Franck78/NANAO-MS8_29/SHIC101.jpg

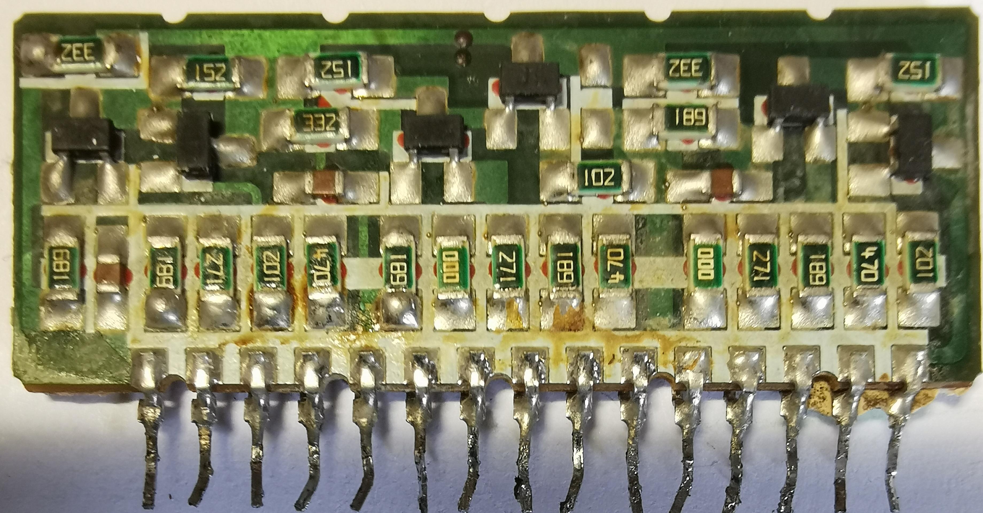
SHIC101.jpg
