Franck78/NANAO-MS8_29/SHIC103-b.jpg

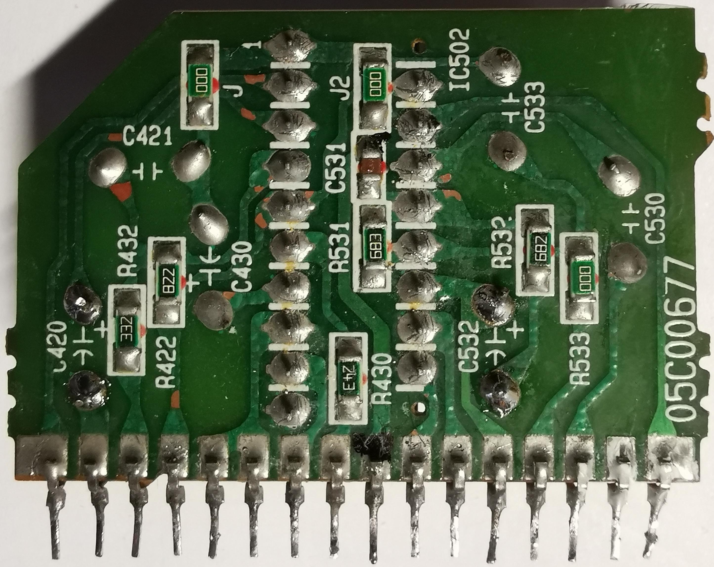
SHIC103-b.jpg
