Franck78/NANAO-MS8_29/SHIC102.jpg

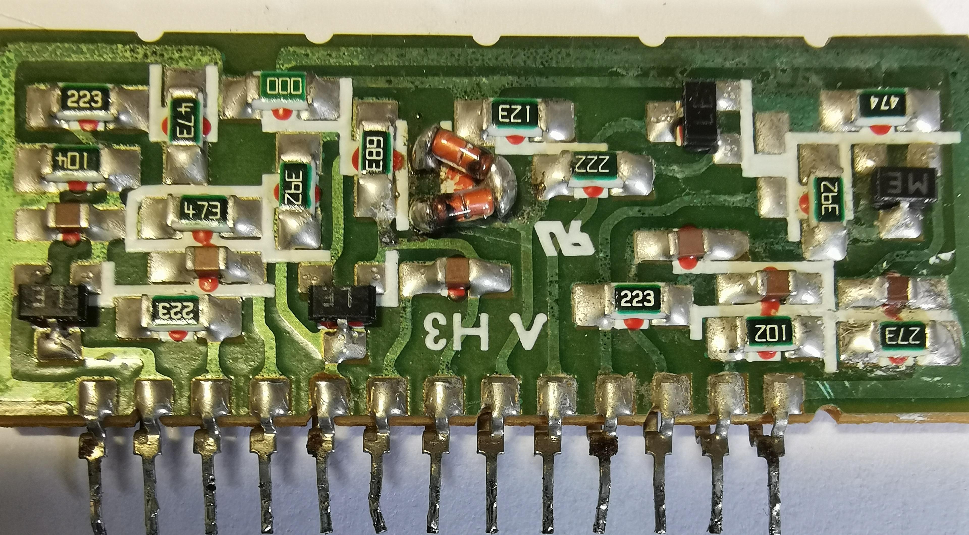
SHIC102.jpg
