Franck78/NANAO-MS8_29/SHIC103-a.jpg

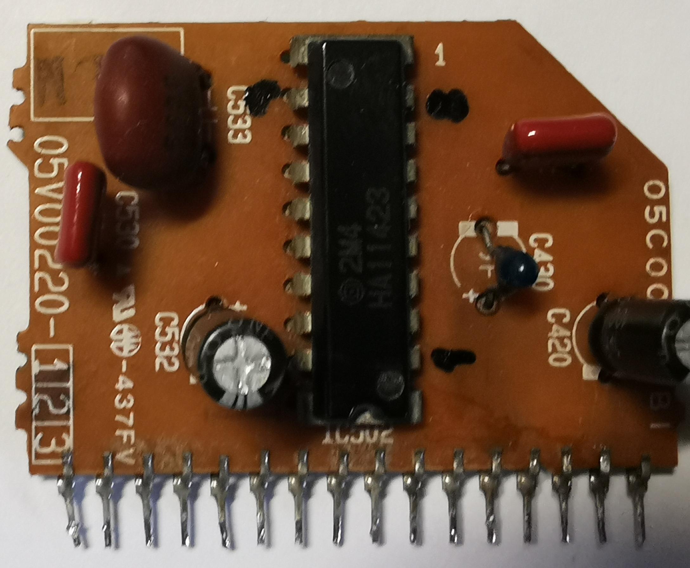
SHIC103-a.jpg
