Franck78/NANAO-MS8_29/SHIC402-a.jpg

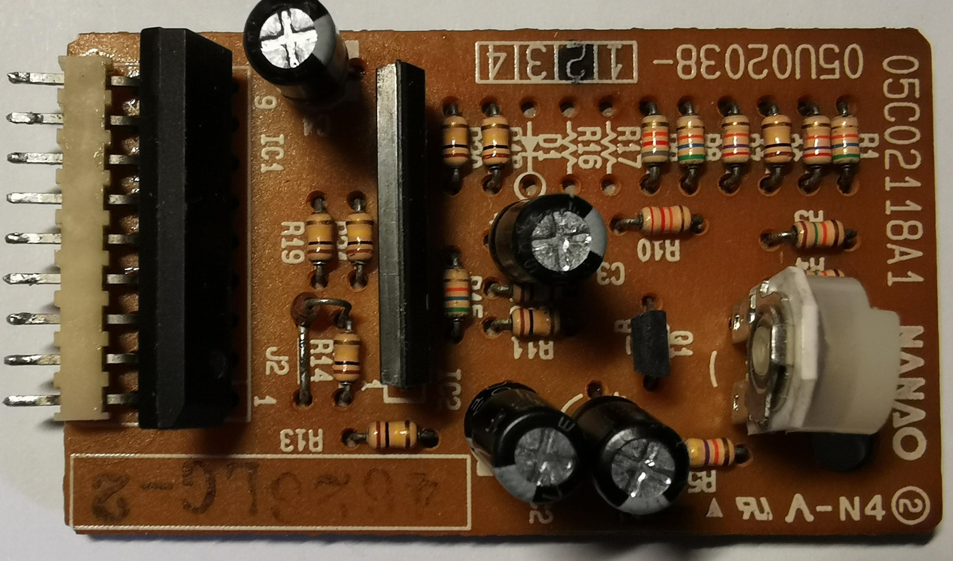
SHIC402-a.jpg
