Franck78/NANAO-MS8_29/SHIC402-b.jpg

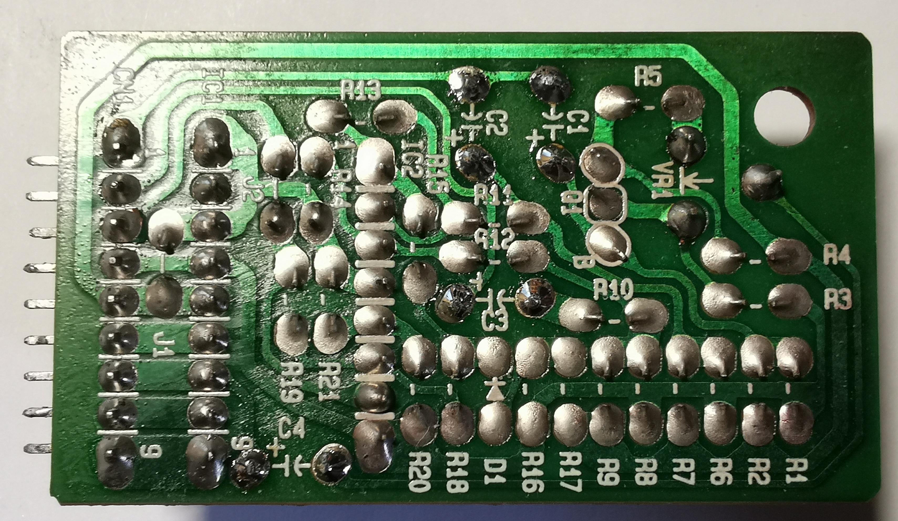
SHIC402-b.jpg
