Franck78/NANAO-MS8_29/nanao-ms8-29.pdf

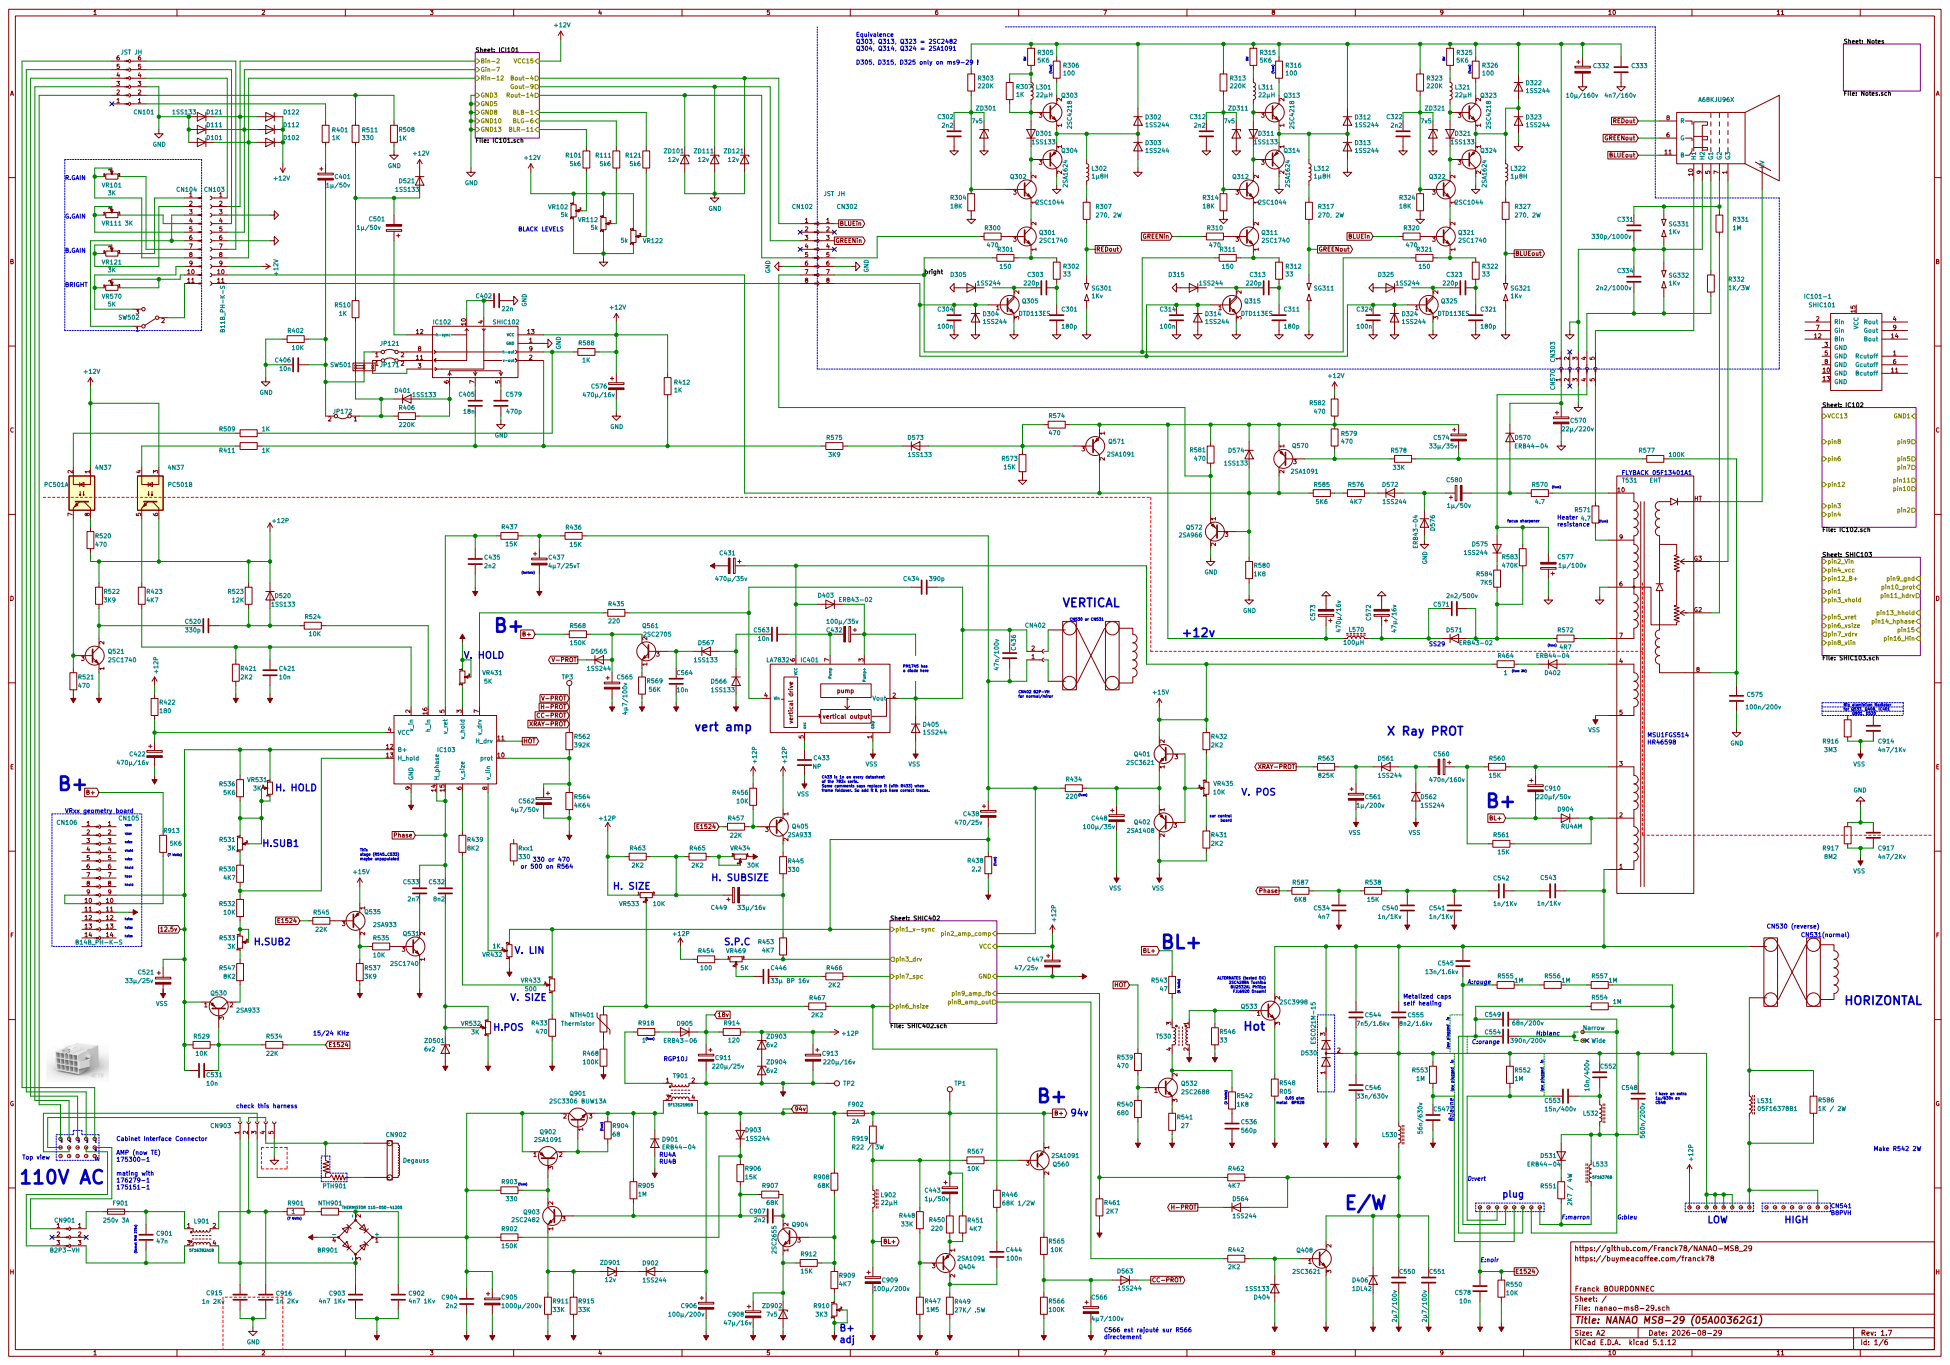
[picture p7: page 1]

Sheet: Notes File: Notes.sch

for Q533, Q408, IC401 Big aluminium Radiator Q901, D530 V. LIN

MSU1FGS514 HR46598 low plugged in low plugged in

C433 is 1n on every datasheet of the 783x serie. Some comments says replace it (with R433) when

frame foldover. So add it !, pcb have correct traces. H.POS

ALTERNATES (tested OK) 2SC4288A Toshiba BU2532AL Philips FJL6920 Onsemi (fuse)

1µ/630v on C548 low plugged in

Cabinet Interface Connector AMP (now TE) 175300-1 mating with

https://github.com/Franck78/NANAO-MS8_29
https://buymeacoffee.com/franck78

Id: 1/6 Title: NANAO MS8-29 (05A00362G1) File: nanao-ms8-29.sch Sheet: / Franck BOURDONNEC

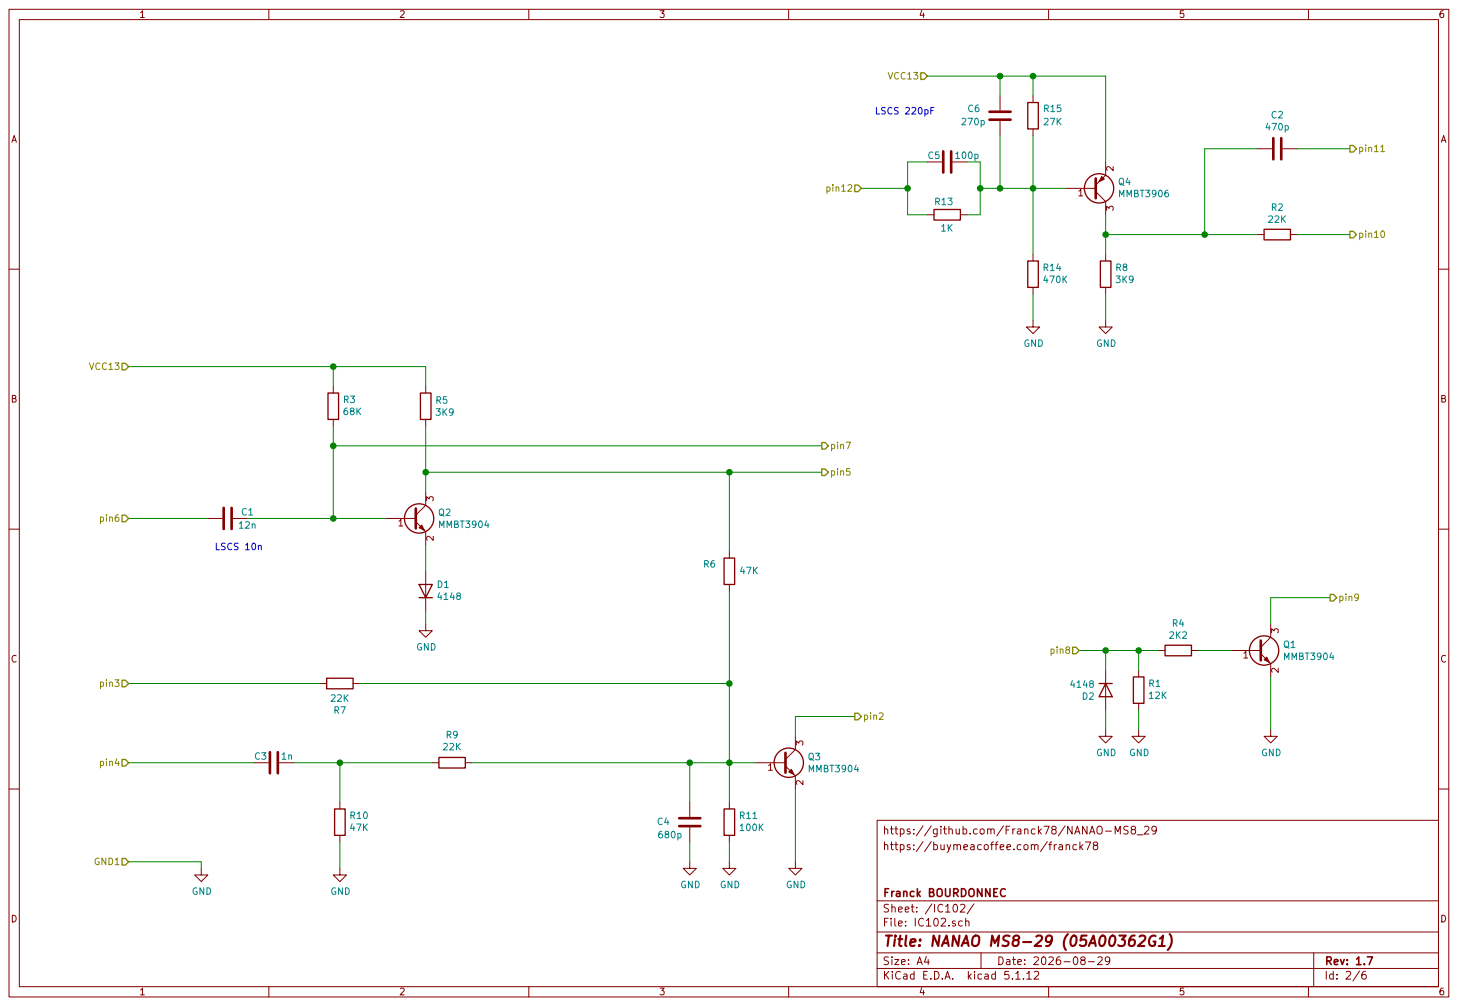
[picture p8: page 2]

https://github.com/Franck78/NANAO-MS8_29 R10

Id: 2/6 Title: NANAO MS8-29 (05A00362G1) File: IC102.sch Sheet: /IC102/ Franck BOURDONNEC

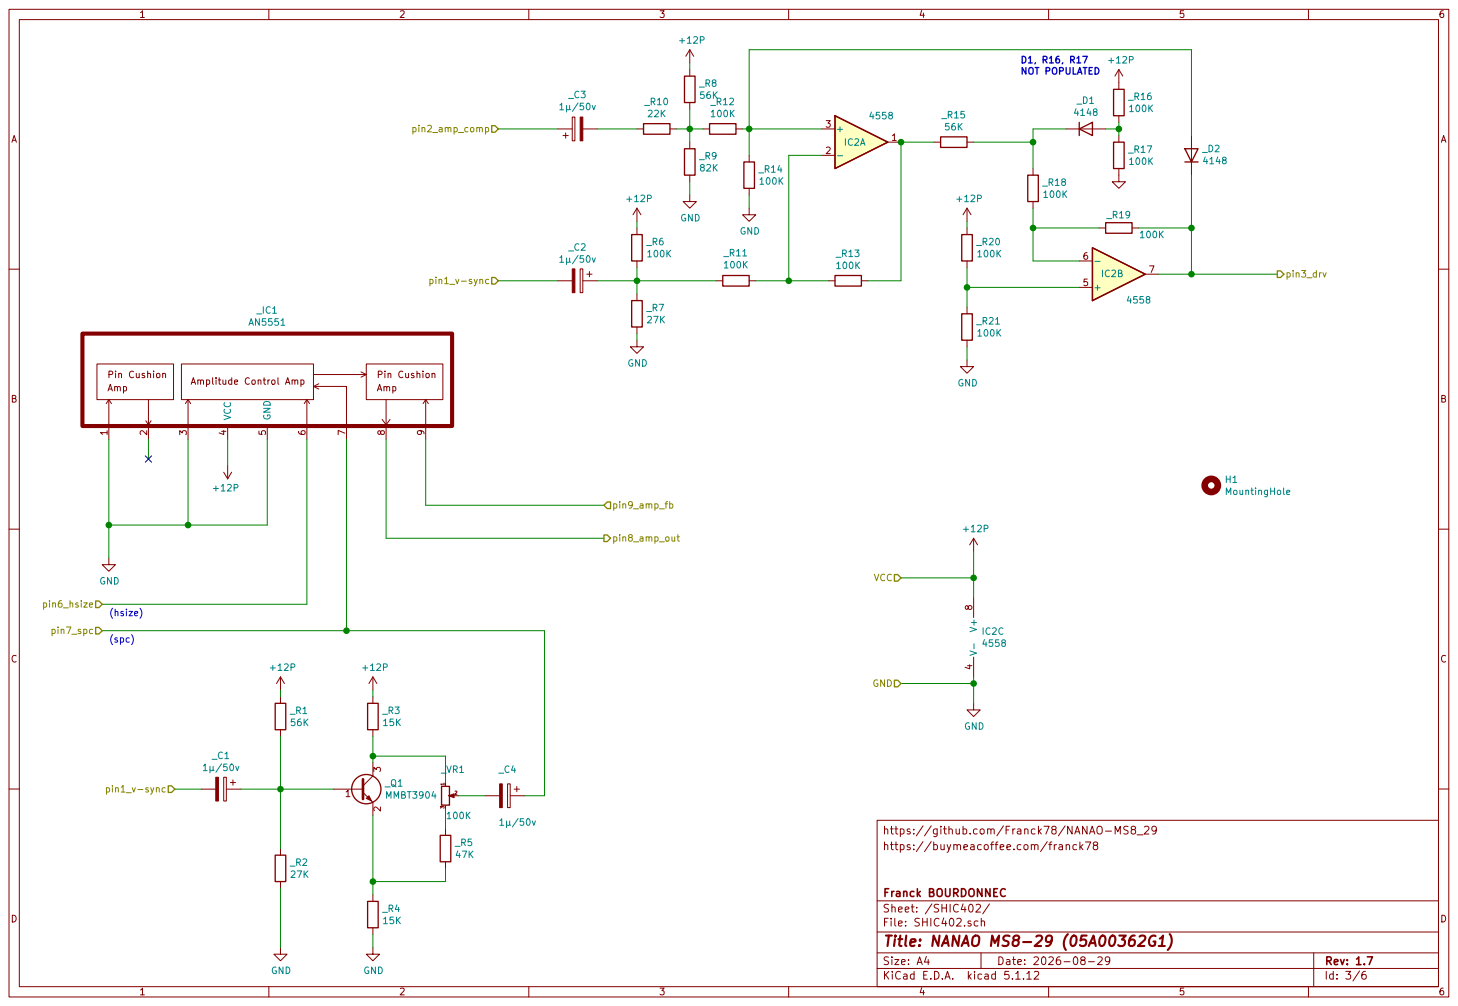
[picture p9: page 3]

https://github.com/Franck78/NANAO-MS8_29
https://buymeacoffee.com/franck78

Id: 3/6 Title: NANAO MS8-29 (05A00362G1) File: SHIC402.sch Sheet: /SHIC402/ Franck BOURDONNEC

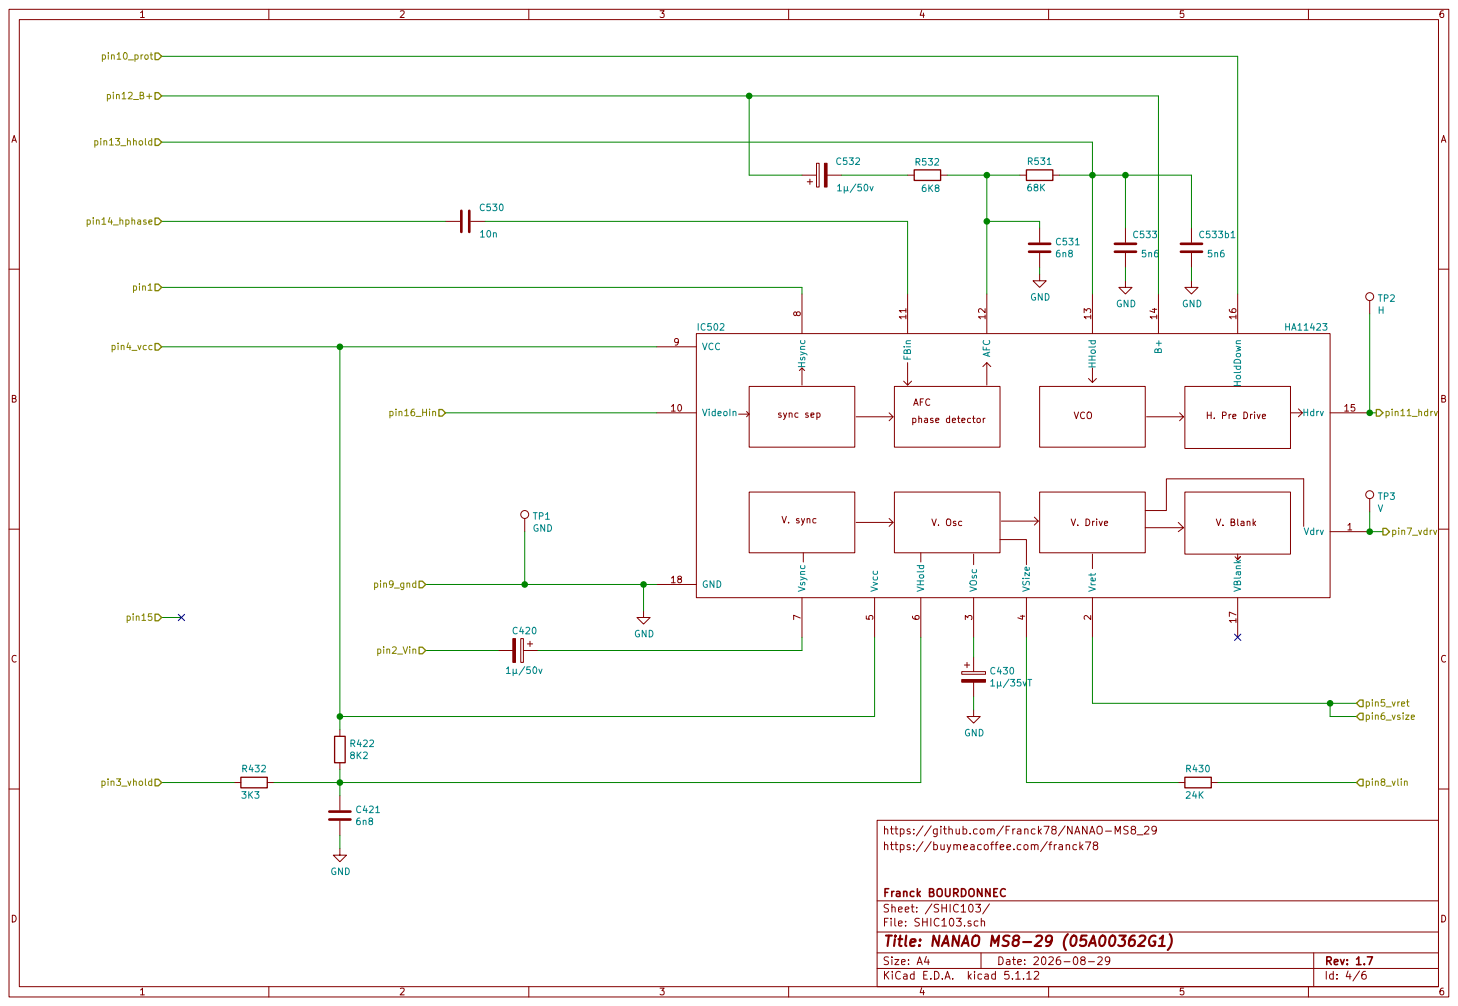
[picture p10: page 4]

https://github.com/Franck78/NANAO-MS8_29 C420

Id: 4/6 Title: NANAO MS8-29 (05A00362G1) File: SHIC103.sch Sheet: /SHIC103/ Franck BOURDONNEC

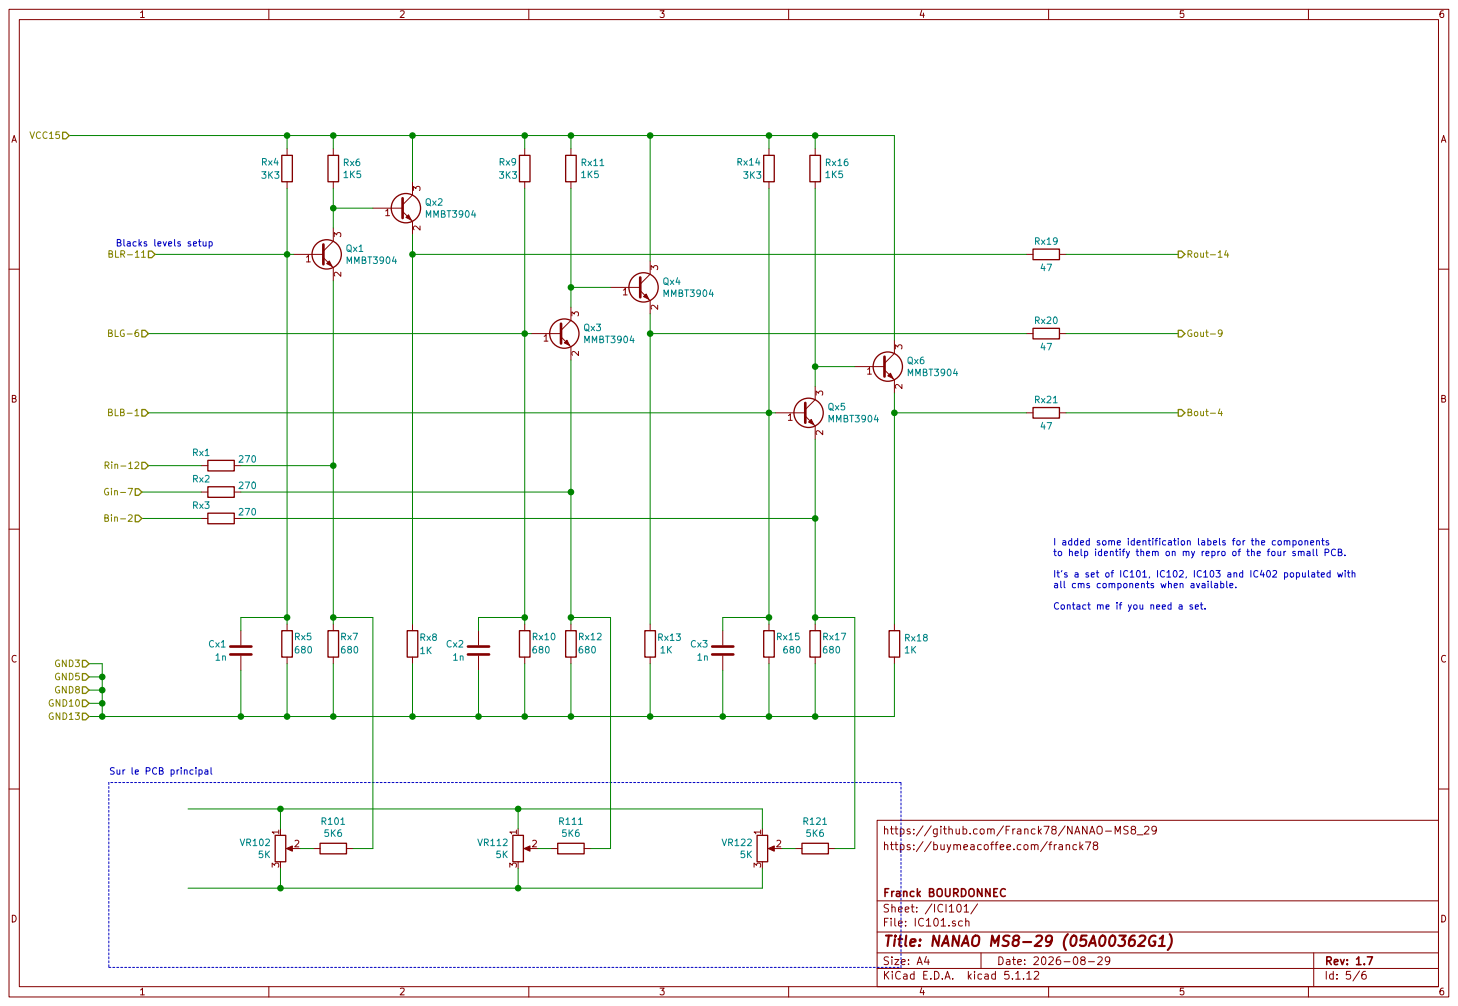
[picture p11: page 5]

I added some identification labels for the components
to help identify them on my repro of the four small PCB.

It's a set of IC101, IC102, IC103 and IC402 populated with
all cms components when available.

Contact me if you need a set.

https://github.com/Franck78/NANAO-MS8_29 Rx15

Sur le PCB principal

Id: 5/6 Title: NANAO MS8-29 (05A00362G1) File: IC101.sch Sheet: /ICI101/ Franck BOURDONNEC

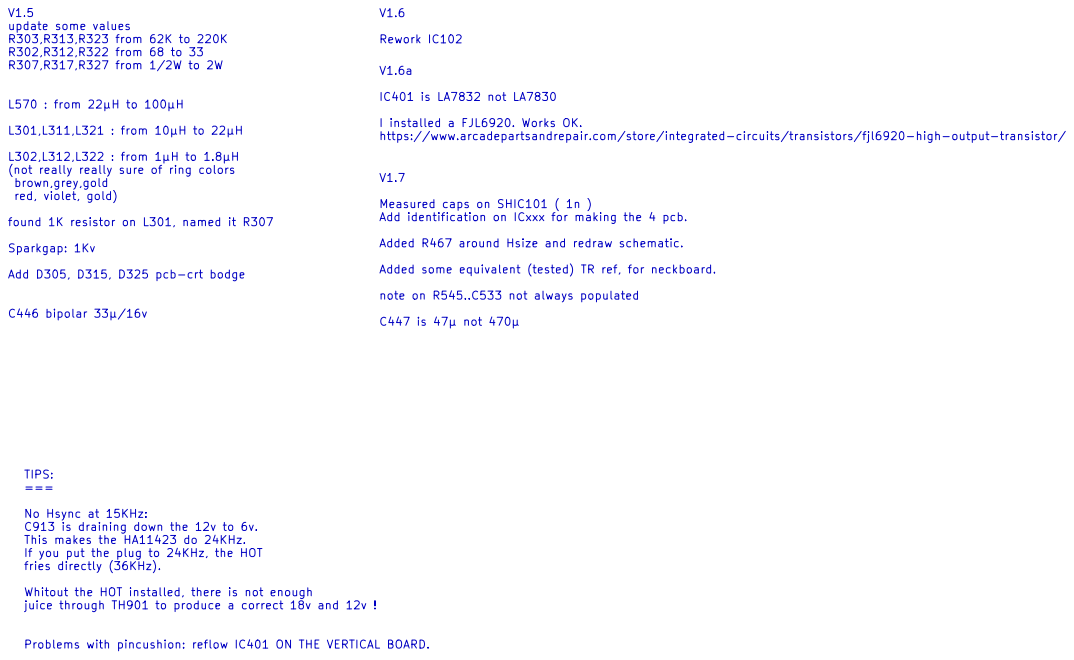
[picture p12: page 6]

update some values R303,R313,R323 from 62K to 220K R302,R312,R322 from 68 to 33 R307,R317,R327 from 1/2W to 2W

I installed a FJL6920. Works OK. https://www.arcadepartsandrepair.com/store/integrated-circuits/transistors/fjl6920-high-output-transistor/ V1.7 Measured caps on SHIC101 ( 1n )

L302,L312,L322 : from 1µH to 1.8µH
(not really really sure of ring colors
brown,grey,gold
red, violet, gold)

Add identification on ICxxx for making the 4 pcb. Added R467 around Hsize and redraw schematic. Added some equivalent (tested) TR ref, for neckboard.

found 1K resistor on L301, named it R307 Sparkgap: 1Kv

Add D305, D315, D325 pcb-crt bodge

note on R545..C533 not always populated

C447 is 47µ not 470µ TIPS: === No Hsync at 15KHz:

C913 is draining down the 12v to 6v. This makes the HA11423 do 24KHz.

If you put the plug to 24KHz, the HOT
fries directly (36KHz).

Whitout the HOT installed, there is not enough
juice through TH901 to produce a correct 18v and 12v !

Problems with pincushion: reflow IC401 ON THE VERTICAL BOARD.

https://github.com/Franck78/NANAO-MS8_29
https://buymeacoffee.com/franck78

Id: 6/6 Title: NANAO MS8-29 (05A00362G1) File: Notes.sch Sheet: /Notes/ Franck BOURDONNEC
