Franck78/NANAO-MS8_29/IC101.sch

## KiCad design IC101.sch (2026-08-29)

Schematic: IC101.sch

Parts:
Cx1, Cx2, Cx3: 1n; C_0805_2012Metric_Pad1.18x1.45mm_HandSolder; LCSC C46653
Qx1, Qx2, Qx3, Qx4, Qx5, Qx6: MMBT3904; SOT-23; LCSC C20526
R101, R111, R121: 5K6
Rx1, Rx2, Rx3: 270; R_0805_2012Metric_Pad1.20x1.40mm_HandSolder; LCSC C326608
Rx4, Rx9, Rx14: 3K3; R_0805_2012Metric_Pad1.20x1.40mm_HandSolder; LCSC C26010
Rx5, Rx7, Rx10, Rx12, Rx15, Rx17: 680; R_0805_2012Metric_Pad1.20x1.40mm_HandSolder; LCSC C17798
Rx6, Rx11, Rx16: 1K5; R_0805_2012Metric_Pad1.20x1.40mm_HandSolder; LCSC C4310
Rx8, Rx13, Rx18: 1K; R_0805_2012Metric_Pad1.20x1.40mm_HandSolder; LCSC C17513
Rx19, Rx20, Rx21: 47; R_0805_2012Metric_Pad1.20x1.40mm_HandSolder; LCSC C17714
VR102, VR112, VR122: 5K

Notes on the sheet:
Blacks levels setup
Sur le PCB principal
I added some identification labels for the components to help identify them on my repro of the four small PCB. It's a set of IC101, IC102, IC103 and IC402 populated with all cms components when available. Contact me if you need a set.
