Franck78/NANAO-MS8_29/IC102.sch

## KiCad design IC102.sch (2026-08-29)

Schematic: IC102.sch

Parts:
C1: 12n; C_0805_2012Metric_Pad1.18x1.45mm_HandSolder; LCSC C1710
C2: 470p; C_0805_2012Metric_Pad1.18x1.45mm_HandSolder; LCSC C1743
C3: 1n; C_0805_2012Metric_Pad1.18x1.45mm_HandSolder; LCSC C46653
C4: 680p; C_0805_2012Metric_Pad1.18x1.45mm_HandSolder; LCSC C1754
C5: 100p; C_0805_2012Metric_Pad1.18x1.45mm_HandSolder; LCSC C1790
C6: 270p; C_0805_2012Metric_Pad1.18x1.45mm_HandSolder; LCSC C107145
D1, D2: 4148; D_SOD-323_HandSoldering; LCSC C2128
Q1, Q2, Q3: MMBT3904; SOT-23; LCSC C20526
Q4: MMBT3906; SOT-23; LCSC C2143
R1: 12K; R_0805_2012Metric_Pad1.20x1.40mm_HandSolder; LCSC C17444
R2, R7, R9: 22K; R_0805_2012Metric_Pad1.20x1.40mm_HandSolder; LCSC C17560
R3: 68K; R_0805_2012Metric_Pad1.20x1.40mm_HandSolder; LCSC C17801
R4: 2K2; R_0805_2012Metric_Pad1.20x1.40mm_HandSolder; LCSC C17520
R5: 3K9; R_0805_2012Metric_Pad1.20x1.40mm_HandSolder; LCSC C17614
R6, R10: 47K; R_0805_2012Metric_Pad1.20x1.40mm_HandSolder; LCSC C17713
R8: 3K9; R_0805_2012Metric_Pad1.20x1.40mm_HandSolder
R11: 100K; R_0805_2012Metric_Pad1.20x1.40mm_HandSolder; LCSC C149504
R13: 1K; R_0805_2012Metric_Pad1.20x1.40mm_HandSolder; LCSC C17513
R14: 470K; R_0805_2012Metric_Pad1.20x1.40mm_HandSolder; LCSC C17709
R15: 27K; R_0805_2012Metric_Pad1.20x1.40mm_HandSolder; LCSC C17593

Notes on the sheet:
LSCS 10n
LSCS 220pF
