Franck78/NANAO-MS8_29/SHIC103.sch

## KiCad design SHIC103.sch (2026-08-29)

Schematic: SHIC103.sch

Parts:
C420, C532: 1µ/50v; CP_Radial_D4.0mm_P2.00mm
C421, C531: 6n8; C_0805_2012Metric_Pad1.18x1.45mm_HandSolder; LCSC C1755
C430: 1µ/35vT; CP_Radial_D4.0mm_P2.00mm
C530: 10n; C_0805_2012Metric_Pad1.18x1.45mm_HandSolder; LCSC C1710
C533: 5n6; C_0805_2012Metric_Pad1.18x1.45mm_HandSolder; LCSC C113862
C533b1: 5n6; C_Rect_L7.0mm_W3.5mm_P2.50mm_P5.00mm
IC502: HA11423
R422: 8K2; R_0805_2012Metric_Pad1.20x1.40mm_HandSolder; LCSC C17828
R430: 24K; R_0805_2012Metric_Pad1.20x1.40mm_HandSolder; LCSC C17575
R432: 3K3; R_0805_2012Metric_Pad1.20x1.40mm_HandSolder; LCSC C110574
R531: 68K; R_0805_2012Metric_Pad1.20x1.40mm_HandSolder; LCSC C17801
R532: 6K8; R_0805_2012Metric_Pad1.20x1.40mm_HandSolder; LCSC C17772
TP1: GND; TestPoint_Bridge_Pitch2.54mm_Drill1.0mm
TP2: H; TestPoint_Bridge_Pitch2.54mm_Drill1.0mm
TP3: V; TestPoint_Bridge_Pitch2.54mm_Drill1.0mm
