Franck78/NANAO-MS8_29/SHIC401.sch

## KiCad design SHIC401.sch (2025-07-25)

Schematic: SHIC401.sch

Parts:
C1, C2, C3, C4: 1µ/50v
D1: 1N4148
IC1: AN5551
IC2: M5223
Q1: 2SC1740; TO-92_Inline
R1, R8, R15: 56K
R2, R7: 27K
R3, R4: 15K
R5: 47K
R6, R11, R12, R13, R14, R18, R19, R20, R21: 100K
R9: 82K
R10: 22K
VR1: 100K
