Franck78/NANAO-MS8_29/SHIC402.sch

## KiCad design SHIC402.sch (2026-08-29)

Schematic: SHIC402.sch

Parts:
H1: MountingHole; MountingHole_3.7mm
IC2: 4558; SOIC-8_3.9x4.9mm_P1.27mm
_C1, _C2, _C3, _C4: 1µ/50v; CP_Radial_D4.0mm_P2.00mm
_D1, _D2: 4148; D_SOD-323_HandSoldering; LCSC C2128
_IC1: AN5551; SIP9_Housing_BigPads
_Q1: MMBT3904; SOT-23; LCSC C20526
_R1: 56K; R_0805_2012Metric_Pad1.20x1.40mm_HandSolder
_R2, _R7: 27K; R_0805_2012Metric_Pad1.20x1.40mm_HandSolder
_R3, _R4: 15K; R_0805_2012Metric_Pad1.20x1.40mm_HandSolder
_R5: 47K; R_0805_2012Metric_Pad1.20x1.40mm_HandSolder
_R6, _R11, _R12, _R13, _R16, _R17, _R18, _R19, _R20, _R21: 100K; R_0805_2012Metric_Pad1.20x1.40mm_HandSolder; LCSC C149504
_R8, _R15: 56K; R_0805_2012Metric_Pad1.20x1.40mm_HandSolder; LCSC C17756
_R9: 82K; R_0805_2012Metric_Pad1.20x1.40mm_HandSolder; LCSC C17840
_R10: 22K; R_0805_2012Metric_Pad1.20x1.40mm_HandSolder; LCSC C17560
_R14: 100K; R_0805_2012Metric_Pad1.20x1.40mm_HandSolder
_VR1: 100K; minipot

Notes on the sheet:
D1, R16, R17 NOT POPULATED
(hsize)
(spc)
