Franck78/NANAO-MS8_29/nanao-ms8-29.sch

## KiCad design nanao-ms8-29.sch (2026-08-29)

Schematic: nanao-ms8-29.sch

Parts:
BR901: BF40E2
C301, C311, C321: 180p
C302, C312, C322, C435, C904, C907: 2n2
C303, C313, C323: 220p
C304, C314, C324, C444: 100n
C331: 330p/1000v
C332: 10µ/160v
C333: 4n7/160v
C334: 2n2/1000v
C401, C443, C501, C580: 1µ/50v
C402: 22n
C405: 18n
C406, C421, C531, C563, C564, C578: 10n
C422, C573, C576: 470µ/16v
C431: 470µ/35v
C432, C448: 100µ/35v
C433: NP
C434: 390p
C436: 47n/100v
C437: 4µ7/25vT
C438: 470/25v
C446: 33µ BP 16v
C447: 47/25v
C449: 33µ/16v
C520: 330p
C521: 33µ/25v
C532: 8n2
C533: 2n7
C534: 4n7
C536: 560p
C540, C541, C542, C543: 1n/1Kv
C544: 7n5/1.6kv
C545: 13n/1.6kv
C546: 33n/630v
C547: 56n/630v
C548: 560n/200v
C549: 68n/200v
C550, C551: 2µ7/100v
C552: 10n/400v
C553: 15n/400v
C554: 390n/200v
C555: 8n2/1.6kv
C560: 470n/160v
C561: 1µ/200v
C562: 4µ7/50v
C565, C566: 4µ7/100v
C570: 22µ/220v
C571: 2n2/500v
C572, C908: 47µ/16v
C574: 33µ/35v
C575: 100n/200v
C577: 1µ/100v
C579: 470p
C901: 47n
C902, C903: 4n7 1Kv
C905: 1000µ/200v
C906, C909: 100µ/200v
C910: 220µf/50v
C911: 220µ/25v
C913: 220µ/16v
C914: 4n7/1Kv
C915, C916: 1n 2Kv
C917: 4n7/2Kv
CL1, CL2: COIL
CN101, CN302: JST JH
CN102: Conn_01x08_Male
CN103: B11B_PH-K-S
CN104: Conn_01x11_Male
CN105: B14B_PH-K-S
CN106: Conn_01x14_Male
CN303, CN903: Conn_01x05_Female
CN402: Conn_01x02_Female
CN570: Conn_01x05_Male
CN901: B2P3-VH
CN902: Degauss
D101, D102, D111, D112, D121, D122, D301, D311, D321, D401, D520, D521, D566, D567, D574: 1SS133
D302, D303, D304, D305, D312, D313, D314, D315, D322, D323, D324, D325, D561, D562, D563, D564, D565, D572, D575: 1SS244; D_DO-41_SOD81_P10.16mm_Horizontal
D402, D531, D570, D901: ERB44-04; D_DO-41_SOD81_P10.16mm_Horizontal
D403: ERB43-02
D404, D573: 1SS133; D_DO-41_SOD81_P10.16mm_Horizontal
D405, D902, D903: 1SS244
D406: 1DL42; D_DO-41_SOD81_P10.16mm_Horizontal
D530: ESC021M-15; D_Schottky_x2_Serial_ACK
D571: ERB43-02; D_DO-41_SOD81_P10.16mm_Horizontal
D576: ERB43-04; D_DO-41_SOD81_P10.16mm_Horizontal
D904: RU4AM; D_DO-41_SOD81_P10.16mm_Horizontal
D905: ERB43-06
F901: 250v 3A
F902: 2A
IC101-1: SHIC101
IC102: SHIC102
IC103: SHIC103
IC401: LA7832
JP121, JP171, JP172: Jumper_2_Bridged
L301, L311, L321, L902: 22µH
L302, L312, L322: 1µ8H
L530, L532: x
L531: 05F16378B1
L533: 5F16376B
L570: 100µH
L901: 5F16382A1B
NTH401: Thermistor
NTH901: THERMISTOR 115-050-41205
PC501: 4N37; DIP-8_W7.62mm
PTH901: degauss-pth
Q301, Q311, Q321, Q531: 2SC1740; TO-92_Inline
Q302, Q312, Q322: 2SC1044; TO-126-3_Vertical
Q303, Q313, Q323: 2SC4218; TO-92_Inline
Q304, Q314, Q324: 2SA1624; TO-92_Inline
Q305, Q315, Q325: DTD113ES
Q401: 2SC3621; TO-126-3_Vertical
Q402: 2SA1408
Q404, Q560, Q570, Q571, Q902: 2SA1091
Q405, Q530, Q535: 2SA933; TO-92_Inline
Q408: 2SC3621
Q521: 2SC1740
Q532: 2SC2688; TO-126-3_Vertical
Q533: 2SC3998; TO-126-3_Vertical
Q561: 2SC2705; TO-126-3_Vertical
Q572: 2SA966
Q901: 2SC3306 BUW13A
Q903: 2SC2482
Q904: 2SC2655
R101, R111, R121: 5k6
R300, R310, R320, R433, R520, R521, R539, R574, R579, R581, R582: 470
R301, R311, R321: 150
R302, R312, R322, R546: 33
R303, R313, R323, R406: 220K
R304, R314, R324: 18K
R305, R315, R325, R536, R585, R913: 5K6
R306, R316, R326, R454: 100
R307, R317, R327: 270, 2W
R331, R552, R553, R554, R555, R556, R557, R905: 1M
R332: 1K/3W
R401, R411, R412, R508, R509, R510, R588: 1K
R402, R456, R524, R529, R532, R535, R550, R565, R567: 10K
R421, R431, R432, R442, R463, R465, R466, R467: 2K2
R422: 180
R423, R451, R453, R462, R530, R576, R909: 4K7
R434, R435, R450: 220
R436, R437, R538, R560, R561, R573, R906, R912: 15K
R438: 2.2
R439, R547: 8K2
R445, R511, R903: 330
R446: 68K 1/2W
R447: 1M5
R448, R578, R911, R915: 33K
R449: 27K/ .5W
R457, R534, R545: 22K
R461: 2K7
R464, R901, R918: 1
R468, R566, R577: 100K
R522, R537, R575: 3K9
R523: 12K
R531, R533: 3K
R540: 680
R541: 27
R542, R580: 1K8
R543: 47
R548: R05
R551: 2K7 / 4W
R562: 392K
R563: 825K
R564: 4K64
R568, R902: 150K
R569: 56K
R570, R571: 4.7
R572: 4R7
R583: 470K
R584: 7K5
R586: 1K / 2W
R587: 6K8
R904: 68
R907, R908: 68K
R910: 3K3
R914: 120
R916: 3M3
R917: 8M2
R919: R22 / 3W
Rxx1: 330
SG301, SG311, SG321, SG331, SG332: 1Kv
SW501: SW2inv
SW502: SW_SPDT
T530: ETH19Y141AY
T531: EHT
T901: 5F13121B1B
TP1, TP2, TP3: TestPoint
TP11, TP17, TP18, TP19, TP20, TP22, TP23, TP24, TP25, TP26, TP27, TP28, TP29, TP30, TP31, TP32, TP33, TP34, TP35, TP36, TP37, TP38, TP39, TP40, TP41: N
TP21: Narrow
TP42: Wide
Tube1: A68KJU96X
VR101, VR111, VR121, VR531, VR532: 3K
VR102, VR112, VR122: 5k
VR431, VR469, VR570: 5K
VR432: 1K
VR433: 500
VR434: 30K
VR435, VR533: 10K
ZD101, ZD111, ZD121, ZD901: 12v
ZD301, ZD311, ZD321, ZD902: 7v5
ZD501, ZD903, ZD904: 6v2
_TP9: N
xCN101: Conn_01x06_Male
xCN901: Conn_01x02_Male
xTP2, xTP3, xTP4, xTP5, xTP6, xTP7, xTP8, xTP10, xTP12, xTP13, xTP14, xTP15, xTP16: N

Notes on the sheet:
(fuse)
Heater resistance
BLACK LEVELS
R.GAIN
G.GAIN
B.GAIN
BRIGHT
CN402 B2P-VH for normal/miror
VERTICAL
(tantale)
(Kemet R46 275v)
RU4A RU4B
H.POS
(7 Watts)
H. HOLD
V. LIN
V. HOLD
(fuse 2W)
HORIZONTAL
CN530 (reverse)
V. SIZE
X Ray PROT
LOW
CN541 B8PVH
HIGH
FLYBACK 05F13401A1
plug
Cabinet Interface Connector AMP (now TE) 175300-1 mating with 176279-1 175151-1
Top view
Metalized caps self healing
Hot
110V AC
(5 Watts)
(2 Watts)
for Q533, Q408, IC401
Big aluminium Radiator
Q901, D530
SS29
RGP10J
CN531(normal)
VRxx geometry board
330 or 470 or 500 on R564
V. POS
sur control board
vpos
vsize
vhold
hhold
hpos
hsize
S.P.C
H. SUBSIZE
H.SUB1
H.SUB2
0.05 ohm metal BPR28
A:rouge
G:bleu
F:marron
B:jaune
D:vert
H:blanc
C:orange
vert amp
BL+
E:noir
15/24 KHz
C566 est rajouté sur R566 directement
H. SIZE
E/W
B+ adj
PM1745 has a diode here
CN530 or CN531
check this harness
I have an extra 1µ/630v on C548
focus sharpener
low plugged in
MSU1FGS514 HR46598
Make R542 2W
+12v
C433 is 1n on every datasheet of the 783x serie. Some comments says replace it (with R433) when frame foldover. So add it !, pcb have correct traces.
ALTERNATES (tested OK) 2SC4288A Toshiba BU2532AL Philips FJL6920 Onsemi
Equivalence Q303, Q313, Q323 = 2SC2482 Q304, Q314, Q324 = 2SA1091 D305, D315, D325 only on ms9-29 !
This stage (R545..C533) maybe unpopulated
94v
