Franck78/NANAO-MS8_29/(commit log)

2025-07-25 Add files via upload
    Initial commit of Nanao MS8-29
    [IC101.sch, IC102.sch, SHIC103.sch, SHIC401.sch, SHIC402.sch, nanao-ms8-29.sch]
2025-07-28 Add files via upload
    Rework degauss/power section
    [nanao-ms8-29.sch]
2025-07-29 Fixe some values
    [nanao-ms8-29.sch]
2025-09-01 Add files via upload
    Redraw some parts, try to be consistent with ref/values positioning.
    Fix an error around C542
    [IC101.sch, IC102.sch, SHIC103.sch, SHIC402.sch, nanao-ms8-29.sch]
2025-10-10 Add files via upload
    Some corrections
    +Buymecoffee ;)
    [IC101.sch, IC102.sch, Notes.sch, SHIC103.sch, SHIC402.sch, nanao-ms8-29.sch]
2025-11-17 Some rearrangements/
    [IC101.sch, IC102.sch, Notes.sch, SHIC103.sch, SHIC402.sch, nanao-ms8-29.sch]
2026-01-30 IC401 is LA7832 not LA7830
    [IC101.sch, IC102.sch, Notes.sch, SHIC103.sch, SHIC402.sch, nanao-ms8-29.sch]
2026-08-29 Some corrections
    [IC101.sch, IC102.sch, Notes.sch, SHIC103.sch, SHIC402.sch, nanao-ms8-29.sch]
